Picatout/ForthEx/readme.md

ForthEx est un projet d'exploration du langage Forth en commencant par la construction d'un petit ordinateur.

Caractéristiques
=================
 * MCU PIC24EP512GP202
 * sortie vidéo monochrome texte 25 lignes de 64 caractères
 * entrée par clavier PS/2
 * mémoire EEPROM SPI 128Ko pour rétention système
 * mémoire RAM SPI  128Ko pour fichier temporaire
 
 Le système Forth sera développé en assembleur et en Forth seulement.

[sie web du projet](http://picatout.github.io/ForthEx/)
 
Schématique
===========

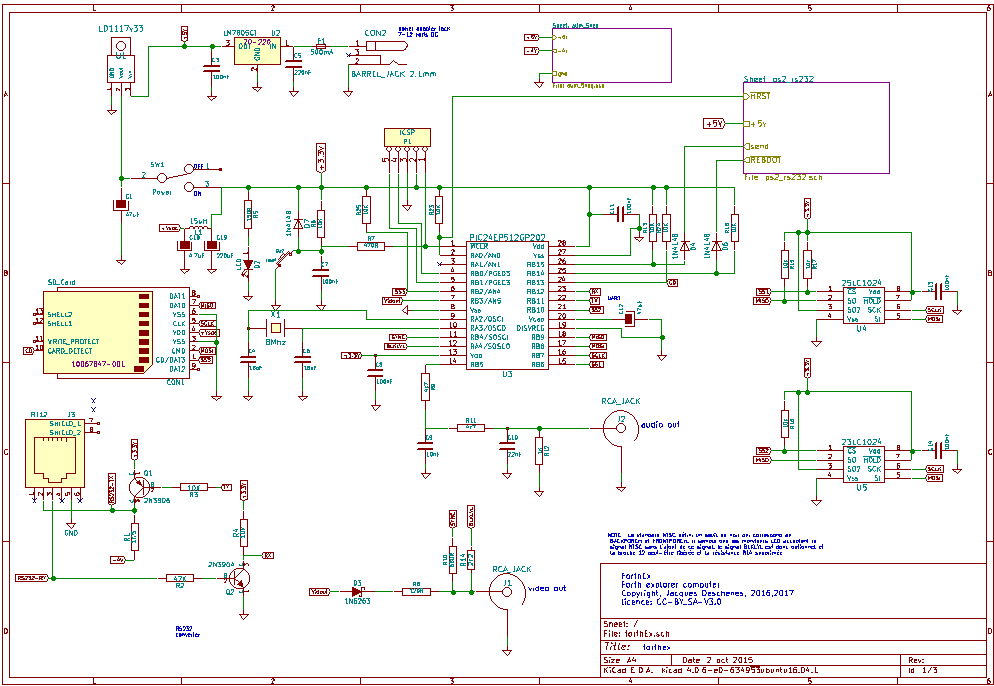
[picture p1: docs/html/img/forthex_schematic.png]
circuit principal


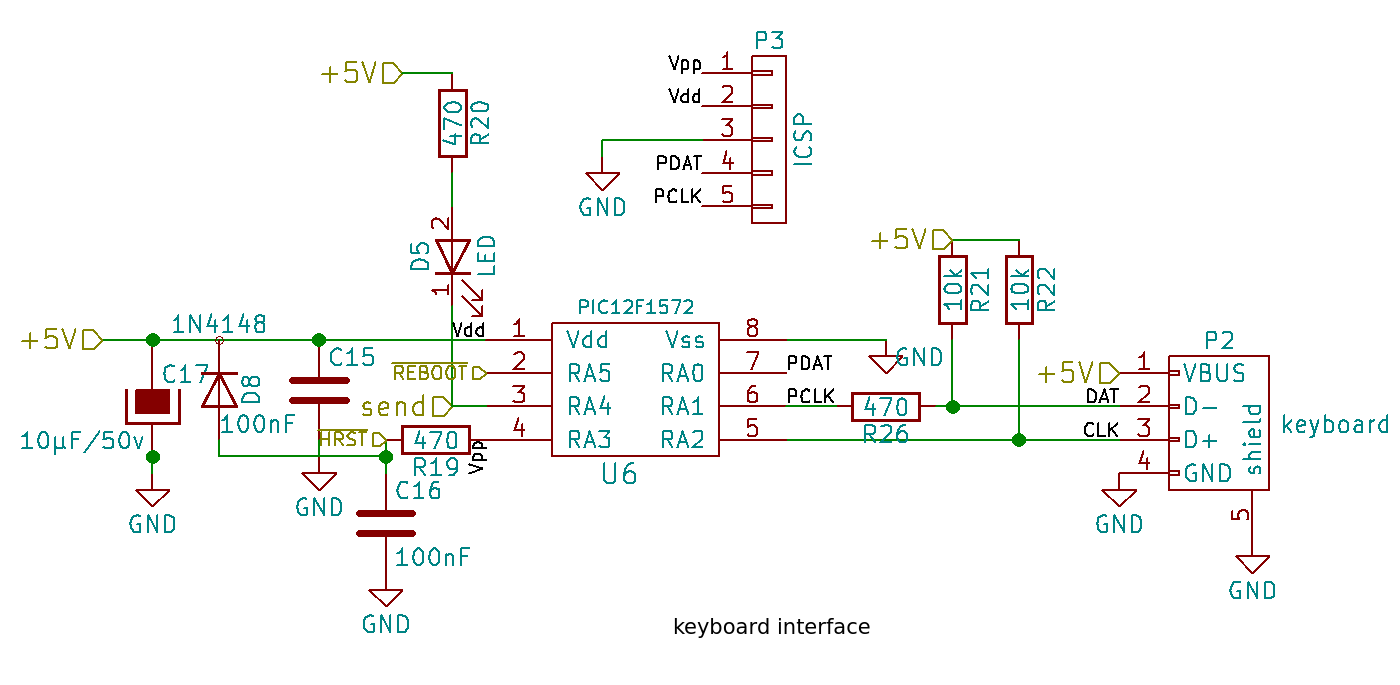
[picture p2: docs/html/img/forthex_schematic_ps2.png]
interface clavier


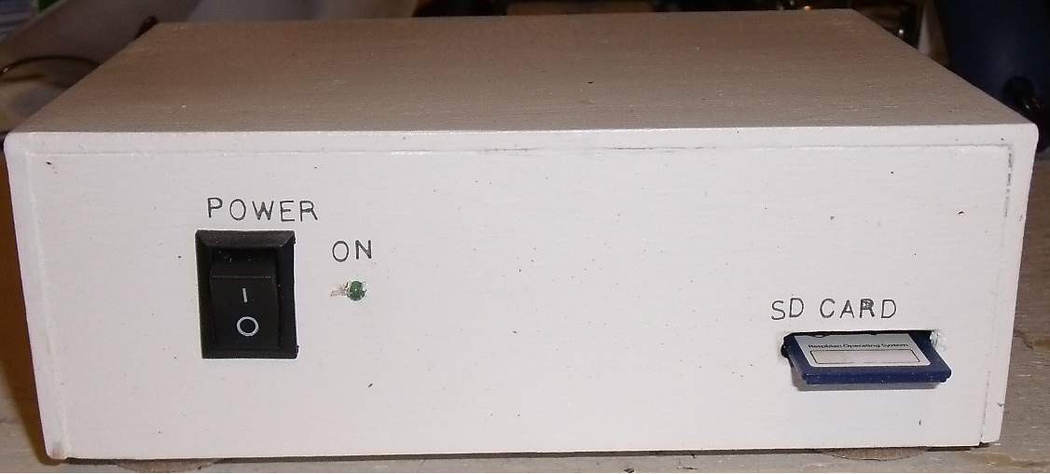
[picture p3: docs/html/img/boitier_face.png]
boitier avant


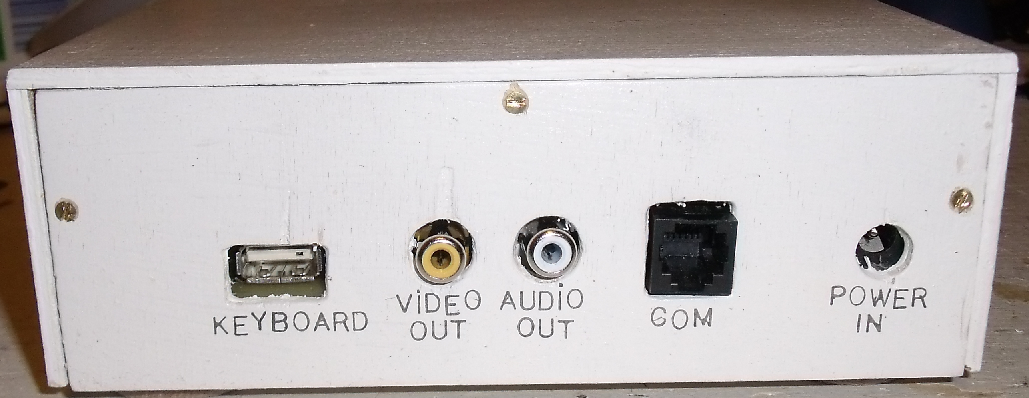
[picture p4: docs/html/img/boitier_arriere.png]
boitier arrière


[vidéo description matérielle](https://youtu.be/hgAJy2Itfcw)

2017-03-24
==========

À ce moment ci le projet est suffisamment avancé pour utiliser l'ordinateur. L'interpréteur et le compilateur sont complétés. Le support de base pour
utiliser la carte SD est complété ainsi que pour la RAM externe, l'EEPROM externe et la mémoire FLASH libre du PIC24EP512GP202. 

[1er vidéo de l'utilisation de l'ordinateur](https://youtu.be/jwFQXd6zAQ0)

2017-06-21
==========
La documentation des 443 mots du dictionnaire est complétée. Il resterais à créer un tutoriel ForthEx.

2020-06-20
==========
Modificiation du readme.md pour ajouter le lien vers le site WEB du projet. Le site contient la référence du langage ainsi qu'un tutoriel.
