Picatout/ForthEx/KiCAD/ForthEx_s/readme.md

ForthEx simple
==============

* version simplifié de l'ordinateur ForthEx

** La carte SD a été supprimée.

L'EEPROM 25LC1024 peut-être enfichable et servir comme seul élément de stockage longue durée des programmes.
