Picatout/ForthEx/docs/html/img/cover_image.png

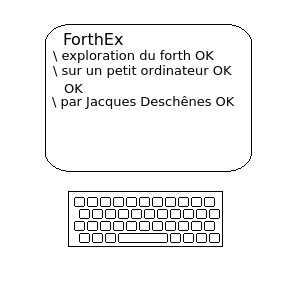
docs/html/img/cover_image.png
