Picatout/ForthEx/docs/html/img/organisation logicielle.png

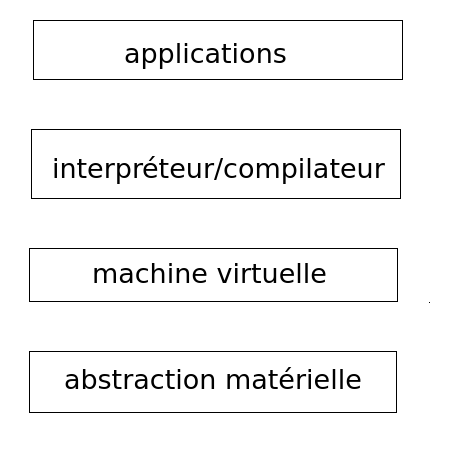
docs/html/img/organisation logicielle.png
