Picatout/ForthEx/docs/html/img/virtual_machine.png

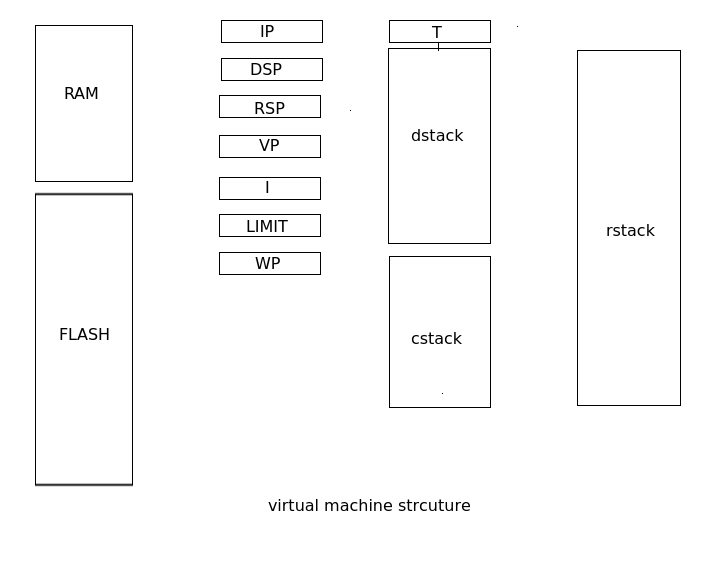
docs/html/img/virtual_machine.png
