Picatout/ForthEx/KiCAD/alim_5neg.sch

## KiCad design KiCAD/alim_5neg.sch (2017-06-25)

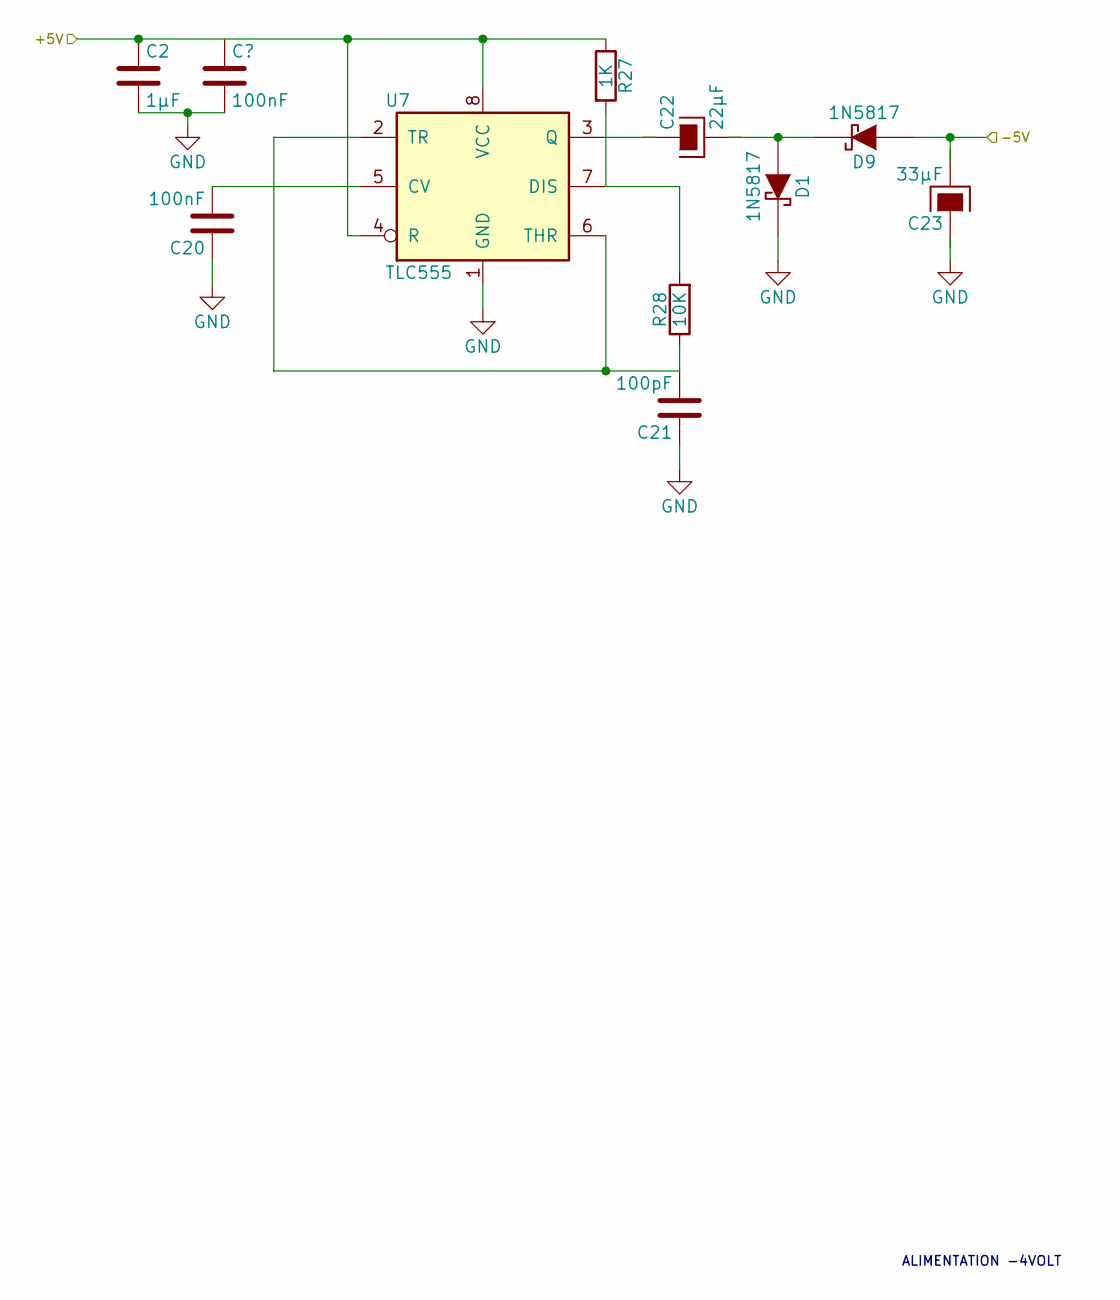
[picture p12: schematic alim_5neg.sch]

Parts:
C2: 1µF
C20: 100nF
C21: 100pF
C22: 22µF
C23: 33µF
D1, D9: 1N5817
R27: 1K
R28: 10K
U7: TLC555

Connections:
+5V: C2.1, R27.1, U7.4 (R), U7.8 (VCC)
-5V: D9.1 (A)
GND: C2.2, C20.1, C21.1, D1.2 (K), U7.1 (GND)
unnamed: C20.2, U7.5 (CV)
unnamed: C21.2, R28.1, U7.2 (TR), U7.6 (THR)
unnamed: D1.1 (A), D9.2 (K)
unnamed: R27.2, R28.2, U7.7 (DIS)

Notes on the sheet:
ALIMENTATION -4VOLT
