Picatout/ForthEx/KiCAD/forthEx.sch

## KiCad design KiCAD/forthEx.sch (2017-06-10)

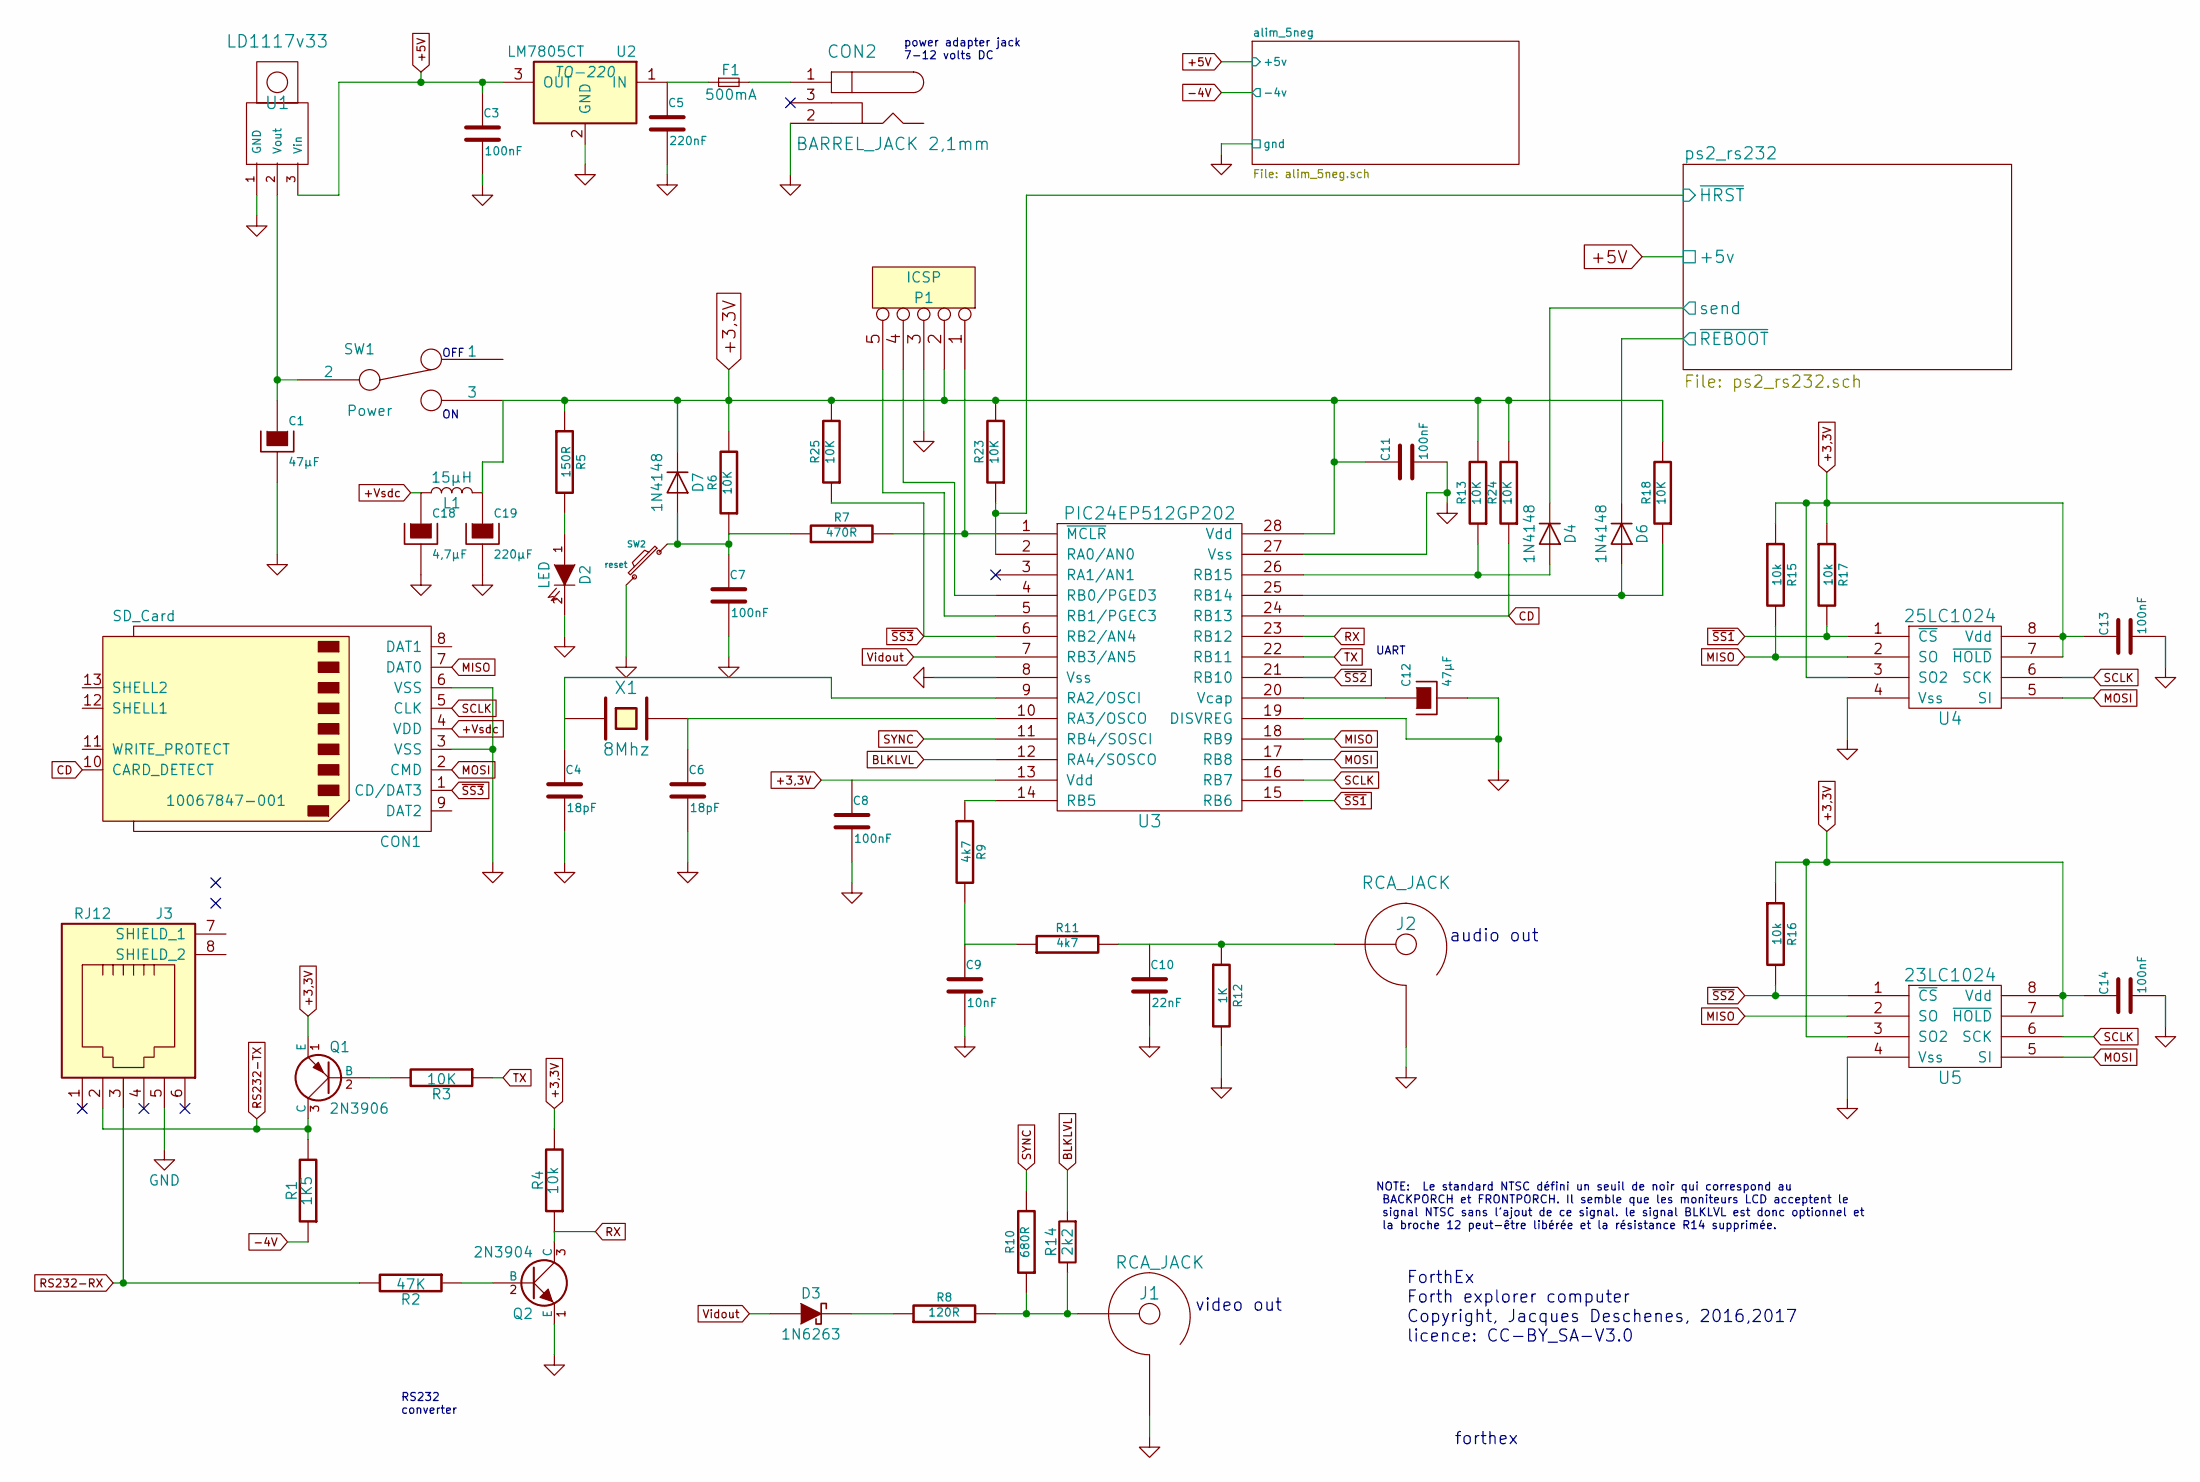
[picture p13: schematic forthEx.sch]

Parts:
C1, C12: 47µF
C3, C7, C8, C11, C13, C14: 100nF
C4, C6: 18pF
C5: 220nF
C9: 10nF
C10: 22nF
C18: 4,7µF
C19: 220µF
CON1: SD_Card; 10067847-001
CON2: BARREL_JACK 2,1mm
D2: LED
D3: 1N6263
D4, D6, D7: 1N4148
F1: 500mA
J1, J2: RCA_JACK
J3: RJ12
L1: 15µH
P1: ICSP
Q1: 2N3906
Q2: 2N3904
R1: 1K5
R2: 47K
R3: 10K
R4: 10k
R5: 150R
R6, R13, R18, R23, R24, R25: 10K
R7: 470R
R8: 120R
R9, R11: 4k7
R10: 680R
R12: 1K
R14: 2k2
R15, R16, R17: 10k
SW1: Power
SW2: reset
U1: LD1117v33
U2: LM7805CT; TO-220
U3: PIC24EP512GP202
U4: 25LC1024
U5: 23LC1024
X1: 8Mhz

Connections:
+3,3V: C11.1, C13.1, C14.1, C19.1, D7.1 (K), L1.2, P1.2, Q1.1 (E), R4.2, R5.1, R6.2, R13.2, R15.1, R16.1, R17.1, R18.2, R23.2, R24.2, R25.2, SW1.3, U3.13 (Vdd), U3.28 (Vdd), U4.3 (SO2), U4.7 (~HOLD), U4.8 (Vdd), U5.3 (SO2), U5.7 (~HOLD), U5.8 (Vdd)
+5V: C3.1, U1.3 (Vin), U2.3 (OUT)
+Vsdc: C18.1, CON1.4 (VDD), L1.1
-4V: R1.1
BLKLVL: R14.2, U3.12 (RA4/SOSCO)
CD: CON1.10 (CARD_DETECT), R24.1, U3.24 (RB13)
GND: C1.2, C3.2, C4.2, C5.2, C6.2, C7.2, C8.2, C9.2, C10.2, C11.2, C12.2, C13.2, C14.2, C18.2, C19.2, CON1.3 (VSS), CON1.6 (VSS), CON2.2, D2.2 (K), J1.~, J2.~, J3.5, P1.3, Q2.1 (E), R12.2, SW2.2, U1.1 (GND), U2.2 (GND), U3.8 (Vss), U3.19 (DISVREG), U3.27 (Vss), U4.4 (Vss), U5.4 (Vss)
MISO: CON1.7 (DAT0), R15.2, U3.18 (RB9), U4.2 (SO), U5.2 (SO)
MOSI: CON1.2 (CMD), U3.17 (RB8), U4.5 (SI), U5.5 (SI)
unnamed: C1.1, SW1.2, U1.2 (Vout)
unnamed: C4.1, U3.9 (RA2/OSCI)
unnamed: C5.1, F1.1, U2.1 (IN)
unnamed: C6.1, U3.10 (RA3/OSCO), X1.2
unnamed: C7.1, D7.2 (A), R6.1, R7.1, SW2.1
unnamed: C9.1, R9.2, R11.1
unnamed: C12.1, U3.20 (Vcap)
unnamed: CON2.1, F1.2
unnamed: D2.1 (A), R5.2
unnamed: D3.2 (K), R8.1
unnamed: D4.2 (A), R13.1, U3.26 (RB15)
unnamed: D6.2 (A), R18.1, U3.25 (RB14)
unnamed: J1.~, R8.2, R10.1, R14.1
unnamed: J2.~, R11.2, R12.1
unnamed: P1.1, R7.2, U3.1 (~MCLR)
unnamed: P1.4, U3.4 (RB0/PGED3)
unnamed: P1.5, U3.5 (RB1/PGEC3)
unnamed: Q1.2 (B), R3.2
unnamed: Q2.2 (B), R2.1
unnamed: R9.1, U3.14 (RB5)
RS232-RX: J3.3, R2.2
RS232-TX: J3.2, Q1.3 (C), R1.2
RX: Q2.3 (C), R4.1, U3.23 (RB12)
SCLK: CON1.5 (CLK), U3.16 (RB7), U4.6 (SCK), U5.6 (SCK)
SYNC: R10.2, U3.11 (RB4/SOSCI)
TX: R3.1, U3.22 (RB11)
Vidout: D3.1 (A), U3.7 (RB3/AN5)
send: D4.1 (K)
~HRST: R23.1, U3.2 (RA0/AN0)
~REBOOT: D6.1 (K)
~SS1: R17.2, U3.15 (RB6), U4.1 (~CS)
~SS2: R16.2, U3.21 (RB10), U5.1 (~CS)
~SS3: CON1.1 (CD/DAT3), R25.1, U3.6 (RB2/AN4)

Notes on the sheet:
audio out
video out
power adapter jack 7-12 volts DC
OFF
UART
RS232 converter
forthex
ForthEx Forth explorer computer Copyright, Jacques Deschenes, 2016,2017 licence: CC-BY_SA-V3.0
NOTE: Le standard NTSC défini un seuil de noir qui correspond au BACKPORCH et FRONTPORCH. Il semble que les moniteurs LCD acceptent le signal NTSC sans l'ajout de ce signal. le signal BLKLVL est donc optionnel et la broche 12 peut-être libérée et la résistance R14 supprimée.
