Picatout/ForthEx/KiCAD/ps2_rs232.sch

## KiCad design KiCAD/ps2_rs232.sch (2017-06-10)

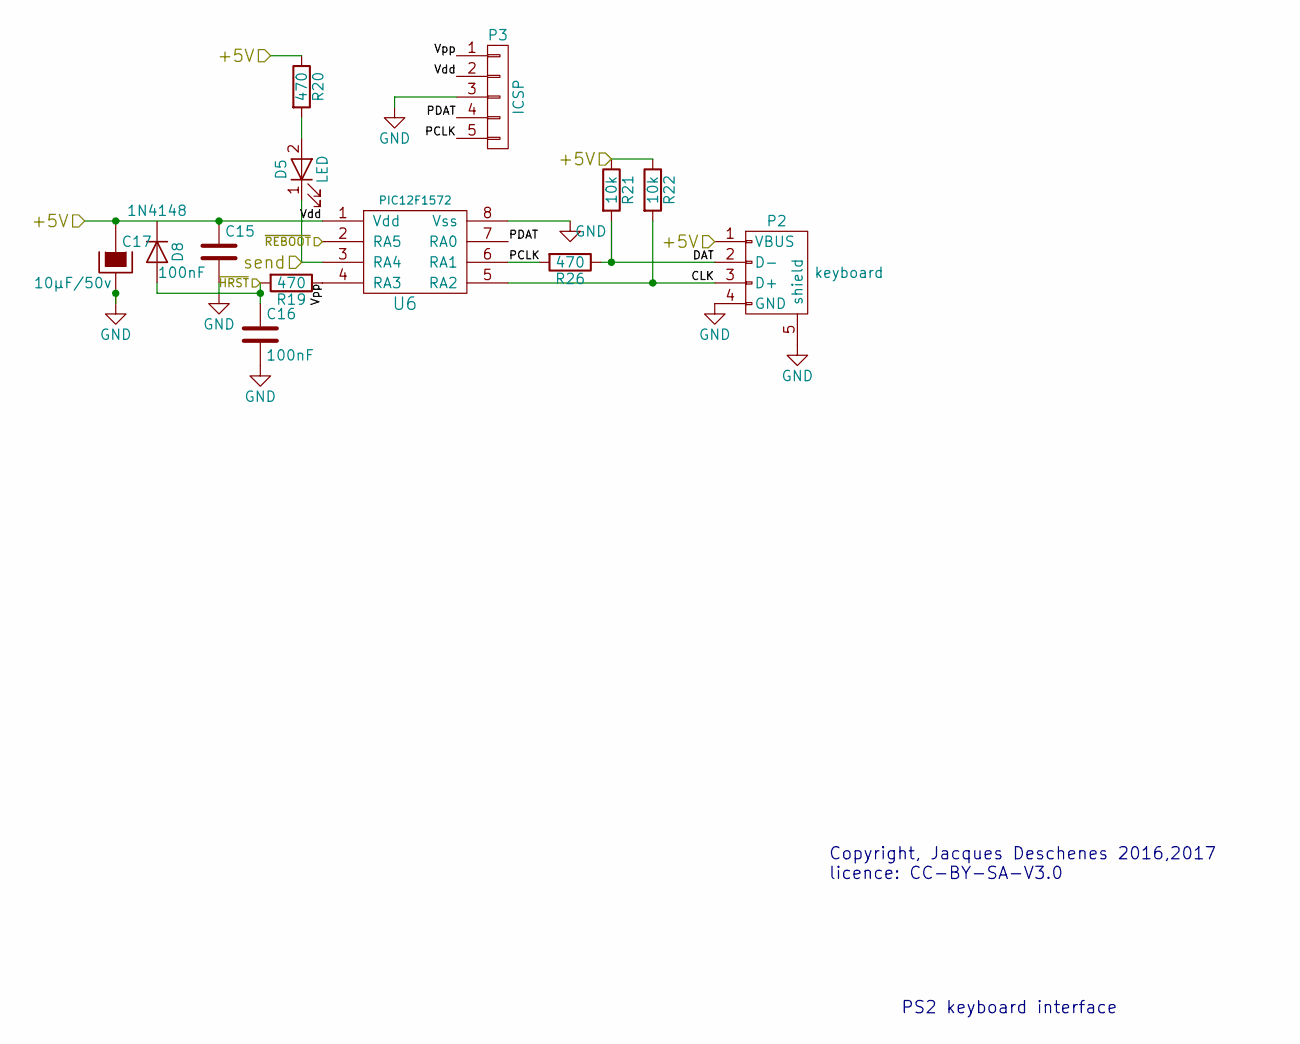
[picture p14: schematic ps2_rs232.sch]

Parts:
C15, C16: 100nF
C17: 10µF/50v
D5: LED
D8: 1N4148
P2: keyboard
P3: ICSP
R19, R20, R26: 470
R21, R22: 10k
U6: PIC12F1572

Connections:
+5V: C15.1, C17.1, P2.1 (VBUS), P3.2, R20.1, R21.1, R22.1, U6.1 (Vdd)
CLK: P2.3 (D+), R22.2, U6.5 (RA2)
DAT: P2.2 (D-), R21.2, R26.1
GND: C15.2, C16.1, C16.2, C17.2, D8.2 (A), P2.4 (GND), P2.5 (shield), P3.3, R19.2, U6.8 (Vss)
unnamed: D5.2 (A), R20.2
PCLK: P3.5, R26.2, U6.6 (RA1)
PDAT: P3.4, U6.7 (RA0)
Vpp: P3.1, R19.1, U6.4 (RA3)
send: D5.1 (K), U6.3 (RA4)
~REBOOT: U6.2 (RA5)

Notes on the sheet:
PS2 keyboard interface
Copyright, Jacques Deschenes 2016,2017 licence: CC-BY-SA-V3.0
