Picatout/ForthEx/KiCAD/ForthEx_s/eeprom.sch

## KiCad design KiCAD/ForthEx_s/eeprom.sch (2017-07-10)

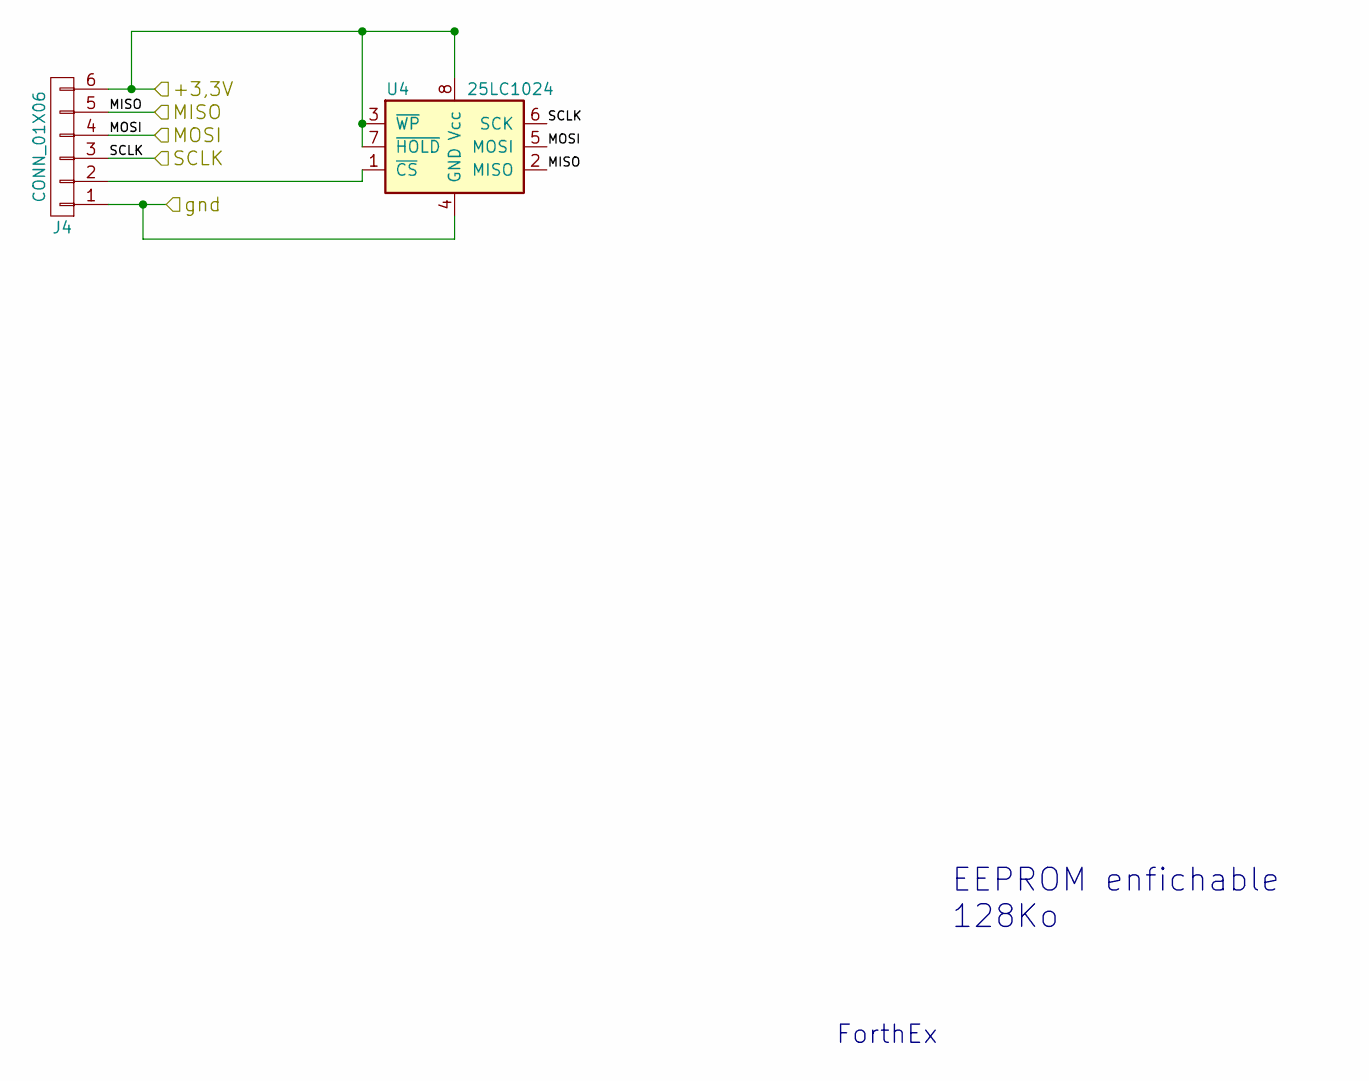
[picture p15: schematic eeprom.sch]

Parts:
J4: CONN_01X06
U4: 25LC1024

Connections:
+3,3V: J4.6, U4.3 (~WP), U4.7 (~HOLD), U4.8 (Vcc)
MISO: J4.5, U4.2 (MISO)
MOSI: J4.4, U4.5 (MOSI)
unnamed: J4.2, U4.1 (~CS)
SCLK: J4.3, U4.6 (SCK)
gnd: J4.1, U4.4 (GND)

Notes on the sheet:
EEPROM enfichable 128Ko
ForthEx
