Picatout/ForthEx/(commit log)

2015-09-12 KiCAD schematic
    [forthEx.sch]
2015-09-27 travail sur tvout.s
    [forthEx.sch]
2015-10-03 travail sur keyboard.s
    [forthEx.sch]
2015-10-06 schématique ajout rs-232
    [forthEx.sch]
2016-05-04 changement de processeur
    adaptation matérielle et logicielle
    [forthEx.sch]
2016-10-19 modification schématique
    enlevé support pile
    ajout régulateur 5 volt pour clavier
    ajout support carte SD
    [forthEx.sch]
2016-10-21 ajout kbd_send
    ajout commande KCMD_RESET à procédure initialisation
    [forthEx.sch]
2016-11-16 travail sur core.s, core.inc les link ne fonctionnent pas. Je cherche une façon de contourner le problème
2017-01-10 modification circuit
    l'interface avec le clavier est maintenant assuré par un second MCU PIC12F1572. Logiciel modifié en conséquence. le code pour l'interface clavier est dans un projet séparé sur https://github.com/picatout/ps2_rs232
    [forthEx.sch, ps2_rs232.sch]
2017-01-16 ajout code SDCard
    [forthEx.sch, ps2_rs232.sch]
2017-01-26 réorganisation projet
    [forthEx.sch, ps2_rs232.sch]
2017-01-28 ajout de nouveau mots
2017-02-02 ajout de mots modifications de certains autres
2017-02-03 ajout de mots
2017-02-08 débuté travail sur compilateur. Modification aux entête de dictionnaire ajout bit F_MARK pour facilité le trvail de CFA>NFA. Modification du mot CFA>NFA. Création de mots pour le compilateur
2017-02-15 travail sur les structures de contrôle
    DO LOOP +LOOP BEGIN AGAIN IF THEN
2017-02-15 travail sur les structure de contrôle
    testé IF ELSE THEN
    testé CASE OF ENDOF ENDCASE
    débuté travail sur LEAVE
2017-02-17 complété LEAVE,VARIABLE,CONSTANT
    modifié ABORT pour annuler les effets d'une compilation en cours
2017-02-19 travail sur compilateur
    modification au compilateur, suppression de la variable système NEWEST
    écrire et tester DOES>, <BUILDS XJUMP (DOES>)
2017-02-20 modification de >NUMBER
    >NUMBER maintenant accepte les modificateurs de base '$' pour hexadécmial,
    '#' pour décimal et '%' pour binaire. Il accepte aussi les entiers double précisions. Ceux contiennent les caractères suivants ['.',','].
    ajout des mots M* et ?DOUBLE
2017-02-21 retraillé >NUMBER
    Retravailler mot ?NUMBER pour qu'il soit conforme à la EBNF suivante
    ENTIER ::= SIMPLE | DOUBLE
    SIMPLE ::= [PREFIXE][SIGNE]{DIGIT}+
    DOUBLE ::= [PREFIXE][SIGNE]{DIGIT+['.'|',']}+
    PREFIXE ::= '$'|'#'|'%'
    SIGNE ::= '-'
    DIGIT ::= '0'|'1'...base-1
    '-' ::= nombre négatif
    '$' ::= base hexadécimale
    '#' ::= base décimale
    '%' ::= base binaire
2017-02-22 Déplacer la mémoire viédo à la fin de la mémoire RAM. Rendre le dictionnaire insensible à la casse en convertissants tous les noms en majuscules. Suppression du mot code INFLOOP, peut-être créer dans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
2017-02-23 Supprimer CFILL et réparer FILL Variable dp0 remplacée par constante dp0 cette valeur ne varie pas. ajout des mots E@,CE@,ERASE,USAVE,ULOAD débuté travail sur DSAVE DLOAD
2017-02-24 travail sur la sauvegarde et restauration d'images système dans l'EEPROM
2017-02-25 continuation du travail sur >BOOT et BOOT modification de EERASE
2017-02-28 débogage PGSAVE dans store.s
    Poursuite du débogage de PGSAVE. Toujours pas de solution en vue.
    EEWRITE ne fonctionne pas après le CMOVE. Par contre si j'ajoute
    DUP,DOT, ou simplement DOTS après CMOVE, EEWRITE fonctionne.
    Si j'enlève la copie de la RAM vers le tampon EEWRITE fonctionne.
    J'ai beau examiné le code de CMOVE je ne vois pas ce qui induit
    le problème. A la sortie de CMOVE S: est dans le bon état
2017-03-01 travail dans store.s
    Ajout du mot >BUFFER et modifié mot PGSAVE pour utiliser >BUFFER
    au lieu du code utilisant CMOVE. Conternement du bogue que je n'arrivais
    pas à résoudre.
    Interpréteur et compilateur complété permettant de d'ajouter des mots à partir
    de l'ordinateur forthex lui-même. L'image RAM est sauvegardée dans l'EEPROM
    en utilisant le mot >BOOT et restaurée au démarrage avec le mot BOOT.
2017-03-02 Ajout des mots CHARS, CHAR+ et CHAR [CHAR] ['] Modification du mot WORDS: affiche le nombre de mots trouvés dans le dictionnaire EXIT est maintenant visible. >> à faire: corrigé TONE ajouter FM/MOD S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
    [ps2_rs232.sch]
2017-03-02 Réparé SOUND_INIT et TONE ajouté mots DABS, FM/MOD SM/REM, ?NEGATE complété tous les mots du core selon ref: http://lars.nocrew.org/forth2012/core.html excepté ENVIRONMENT?
    ajout à core extension:
    .( 0<> 2>R 2R> 2R@
2017-03-04 uppression du mot [COMPILE] Ajout de ?DO C
2017-03-07 suppression de <BUILDS et XJUMP mots compilant créer avec CREATE ET DOES> ajout :NONAME
2017-03-10 ajout autochargement image RAM au démarrage à partir de la mémoire FLASH du MCU.
2017-03-11 ajouter section d'initialisation des variables systèmes et modification de VARS_INT. Commencer la modification des mots BOOT et >BOOT pour permettre le chargement système à partir de différents périp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
2017-03-12 Refais le travail de sauvegarde/récupération d'images RAM avec >BOOT et BOOT
2017-03-13 Tests et nettoyage Suppression du mot IP! et PACK$ corrigé 2! corrigé LSHIFT et RSHIFT Ajout constante MSB=0x8000, MAX-INT=32767 et MIN-INT= -32768 Ajout CMOVE> et réécriture de CMOVE
2017-03-15 correction erreur schématique Modifié CREATE et >BODY remplacé RT_CREATE par FETCH_EXEC ajout avortement d'un programme bloqué par CTRL_C
    [forthEx.sch]
2017-03-15 ajout messages pour les réinitialisation causé par CTRL-C, MATCH_EXCEPTION et STACK_ERROR. ajouté outils de débogage mots: DEBUG,BREAK et RESUME, variables: RPBREAK ET DBGEN Modification à QUIT pour 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
2017-03-17 travail sur les fonctions de base du périphérique CRC
2017-03-18 travail sur CRC ajout mot NOT qui inverse la valeur logique. i.e. 0 -> -1, n<>0 -> 0 à faire: continuer le développement support de base carte SD.
2017-03-23 Mot de base pour carte SD complétés SDCINIT,?SDC,SDREAD,SDWRITE
2017-03-23 Ajout d'une image dans documentation
    [forthEx.csv]
2017-03-24 Abandon de l'enchassement de vidéo dans le readme.md, remplacé par des liens.
2017-03-28 ajout division: UD/MOD 32u/16u -> Q:32u R: 16u modifié impression des nombres la conversion des nombres est maintenant basé sur la conversion des entiers doubles. Les entiers simples sont convertis e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
2017-04-04 include la carte SD dans les périphérique boot. ajout des mots ?SDCOK, IMG>SDC et SDC>IMG, NSECTOR dans sdcard.s modfications dans store.s
    [ps2_rs232.sch]
2017-04-05 modication à ACCEPT maintenant CTRL-BACKSPACE efface toute la ligne.
2017-04-06 Modification au système pour pouvoir utiliser le port sériel comme console REMOTE CONSOLE pour transférer la console au port RS-232 LOCAL CONSOLE pour transférer la console au clavier/écran local. Su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
2017-04-07 Travail dans serial.s modificcation au projet ps_rs232 pour que la combinaison CTRL_x où x est une lettre renvoie les même codes que l'émumateur de terminal minicon en mode VT102. modification à ACCE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
    Ajout de CTRL_x pour réentrer la ligne de commande précédente.
2017-04-08 Mise à jour schématique Modification à BOOT, protection contre les images passées date. Lorsque le système est mis à jour les images sauvegardées avant cette mise à jour sont invalides.
    [forthEx.sch, ps2_rs232.sch]
2017-04-11 retravaillé accès périphériques en créant des descripteurs de périphiriques Ajout TBL@ et TBL! dans fichier core.s Travail dans store.s Renommé: BOOT -> IMG@ et >BOOT -> IMG!
2017-04-12 Déboguage: autochargement ne fonctionnais plus. La valeur d'initialisation de bootdev_init était incorrecte. ERASEROWS avait un bogue régressif suite au modifications d'hier.
    À faire: Cet ordinateur a besoin d'un éditeur de texte et d'un moyen de
    sauvegarder et charger des fichiers texte pour réédition ou exécution.
2017-04-18 J'avais oublié de faire git add avant le commit
2017-04-23 Épuration: suppression de FREE dans hardware.s suppression de FREEHEAD, USEDHEAD, LNKSWAP, BSORT, SORTLIST, BMERGE, HDEFRAG dans dynamem.s
    Renommé BLKFREE -> FREE dans dynamem.s
    Ajout de ?>LIST dans dynamem.s
2017-04-25 Modification au générateur vidéo pour ajouter un seuil noir en utilisant OC4.
    Création et travail sur block.s
    Retiré eefs.s du projet.
    [forthEx.sch]
2017-04-26 Travail sur block.s
    Épuration réorganisation:
    modification à RAM>EE
    modification à IMG! et IMG@ qui maintenant ne s'applique qu'à la mémoire flash
    du MCU. Supression de la variable BOOTDEV.
    IMG! renommé IMGSAVE
    IMG@ renommé IMGLOAD
    déplacement du code pour IMGSAVE et IMGSTORE dans flash.s
    mot OK n'est plus dans le dictionnaire est maintenant HEADLESS.
2017-04-27 Les mots définis dans le dictionnaire avec l'attibru F_HIDDEN ont été redéfinis avec la macro HEADLESS, ce qui a permis de sauver de l'espace et d'épurer le dictionnaire. R0,S0 et DP0 sont passés de 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
2017-04-30 Travail sur __T2Interrupt pour améliorer la synchronisation vidéo. Travaril sur vt102.s
2017-05-01 Modifiez encore le générateur vidéo pour vérifier s'il est nécessaire d'inclure un seuil de noir comme indiqué dans la spécification NTSC. Si ça peut fonctionner sans seuil de noir je pourrai libéré 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
    Correction bogue dans serial.s (non résolu à ce moment).
    Travail dans vt102.s
    [forthEx.sch]
2017-05-02 Réécriture de WITHIN dans core.s et renommé MSEC en MS et réécriture du code pour être conforme au standard ANSI. Réécriture de USEC Réécriture de ?COMPILE, maintenant affiche le mot qui a produit l'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
2017-05-03 Travail sur serial.s, abandon de la file en transmission. Réécriture de __T2Interrupt dans TVout.s
    Débogage POSTPONE
    Travail sur vt102.s
2017-05-09 Ajout de PARSE-NAME. Fichier vt102.s ajout de VT-PUTC et modification de VT-EMIT Réécriture de ACCEPT dans core.s ajouté CLS dans console.s et renommé CLS dans TVout.s -> VT-PAGE renommé NEWLINE -> C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
2017-05-09 Modifié BAUD dans serial.s, et ajouté des constantes pour les différentes vitesses supporté. Le mot BAUD maintenant prend comme argument l'une de ces constantes. La vitesse par défaut est passé à 115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
2017-05-11 Écriture de l'outil count.c pour vérifier que dans tous les fichiers *.s le compte des mots du dictionnaire correspond bien la longueur de la chaîne. Plusieurs erreurs ont été détectées et corrigées.
    Renommé TVout.S et font.S en tvout.s et font.s
2017-05-11 valider le retrait de font.S et TVout.s
2017-05-12 Débuté écriture de l'outil docgen.c
2017-05-16 Travail sur la documentaition dans core.s
2017-05-17 Travails ur documentation de core.s
2017-05-19 Documentation dans keyboard.s Documentation dans dynamem.s Documentation dans serial.s Documentation dans hardware.s Documentation dans flash.s Documentation dans sound.s Ajouts de mots dans strings.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
2017-05-22 Réorganisation du code. Ajout des fichiers eds.s et interpret.s
2017-05-23 Travail et BLKED et correction de COUNT et WORDS. Ajout de LNADR dans block.s
2017-05-25 ---------- Modification dans tvout.s, ajout de LC-B/W. Modification dans vt102.s, ajout de VT-B/W. Modification dans console.s ajout de B/W et ajout de la fonction FN_B/W dans les tables LCCONS et SE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
    Travail dans blockEdit.s
2017-06-01 Correcton bogue dans M+ Correction bogue dans FLASH>RAM Correction bogue dans ?DO Ajout des mots F@ FC@L FC@H et IC@
2017-06-01 Renommé dossier documentation en docs réorganisation dossier html Travail de documentation dans flash.s
2017-06-03 Travail dans dynamem.s et block.s Ajout du mot BUFFER: à dynamem.s Ajout de ETYPE dans console.s
2017-06-04 Complété boitier de l'ordinateur. Ajout de ?PRTCHAR et ?QUOTED-CHAR dans strings.s Modification de ?NUMBER dans strings.s Modifié BLKFILTER dans block.s Modification LC-EMIT dans tvout.s Modification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
2017-06-05 Élimination des mots 'SOURCE et #SOURCE dans core.s Transfert de certains mots de core.s vers d'autres fichiers. Correction de la documentation de core.s Correction bogue dans block.s Correction bogu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
2017-06-05 Suppression de MAXCHAR dans blockEdit.s Travail dans blockEdit.s Ajout du mot PROMPT et modifications d'autres définitions.
2017-06-05 ajout de fichiers images
2017-06-09 Travail sur console. Déboger vt102.s, le test suivant plante continuellement. : test begin vt-key vt-emit ; Vérification faite j'en suis venu à la conclusion que le problème est matériel. Je dois mod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
2017-06-10 Modification matériel circuit port rs-232. Tentative de débogage port rs-232.
    [forthEx.sch, ps2_rs232.sch]
2017-06-10 Retravailler vt102.s Vitesse de la console REMOTE améliorée et bogue semble réglé.
2017-06-11 Travail sur la console. Modifications dans console.s,tvout.s et vt102.s Renommé GETCUR -> XY?
2017-06-11 Correction bogue du au renommages de certains mots.
2017-06-12 Travail sur la console
2017-06-14 Complété réorganisation de la console.
2017-06-14 Travail sur la documentation. Retirer le mot INVLN du fichier tvout.s Cacher les mots LC-* dans tvout.s, ces mots ne sont maintentant accessible que par l'utilisation de la console LOCAL. Cachez les 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
2017-06-15 Travail sur la documentation de dynamem.s Travail sur la documentation de flash.s Travail sur la documentaion de hardware.s Travail sur la documentation de interpret.s
2017-06-15 ; arguments: ; d1 Entier double signé, numérateur. ; n1 Entier simple signé, dénominateur. ; retourne: ; n2 Reste de la division. ; n3 Quotient de la division.
2017-06-16 Travail sur documentation sdcard.s Ajout de UD*D dans math.s
2017-06-17 Trvavail sur documentation sdcard.s Corrigé erreur dans initialisation carte SD. Modification à SDBLK>ADR Ajout de fonctionnalité dans sdcard.s ( à compléter).
2017-06-20 Travail de documentation sur serial.s et store.s
2017-06-21 Travail sur la documentation
2017-06-23 ajout de tutoriel.html
2017-06-25 travail tutoriel.html
    [alim_5neg.sch]
2017-06-28 tutoriel, jeu snake, deboguage CASE
2017-07-10 travail sur documentation
    [alim_5neg.sch, eeprom.sch, forthEx.sch, ps2_rs232.sch]
2017-07-14 Transfert définitions de store.s vers block.s
